lrvdijk/ledstrip-dmx-receiver/led-strip-dmx.kicad_pcb

## KiCad design led-strip-dmx.kicad_pcb (2016-02-02)

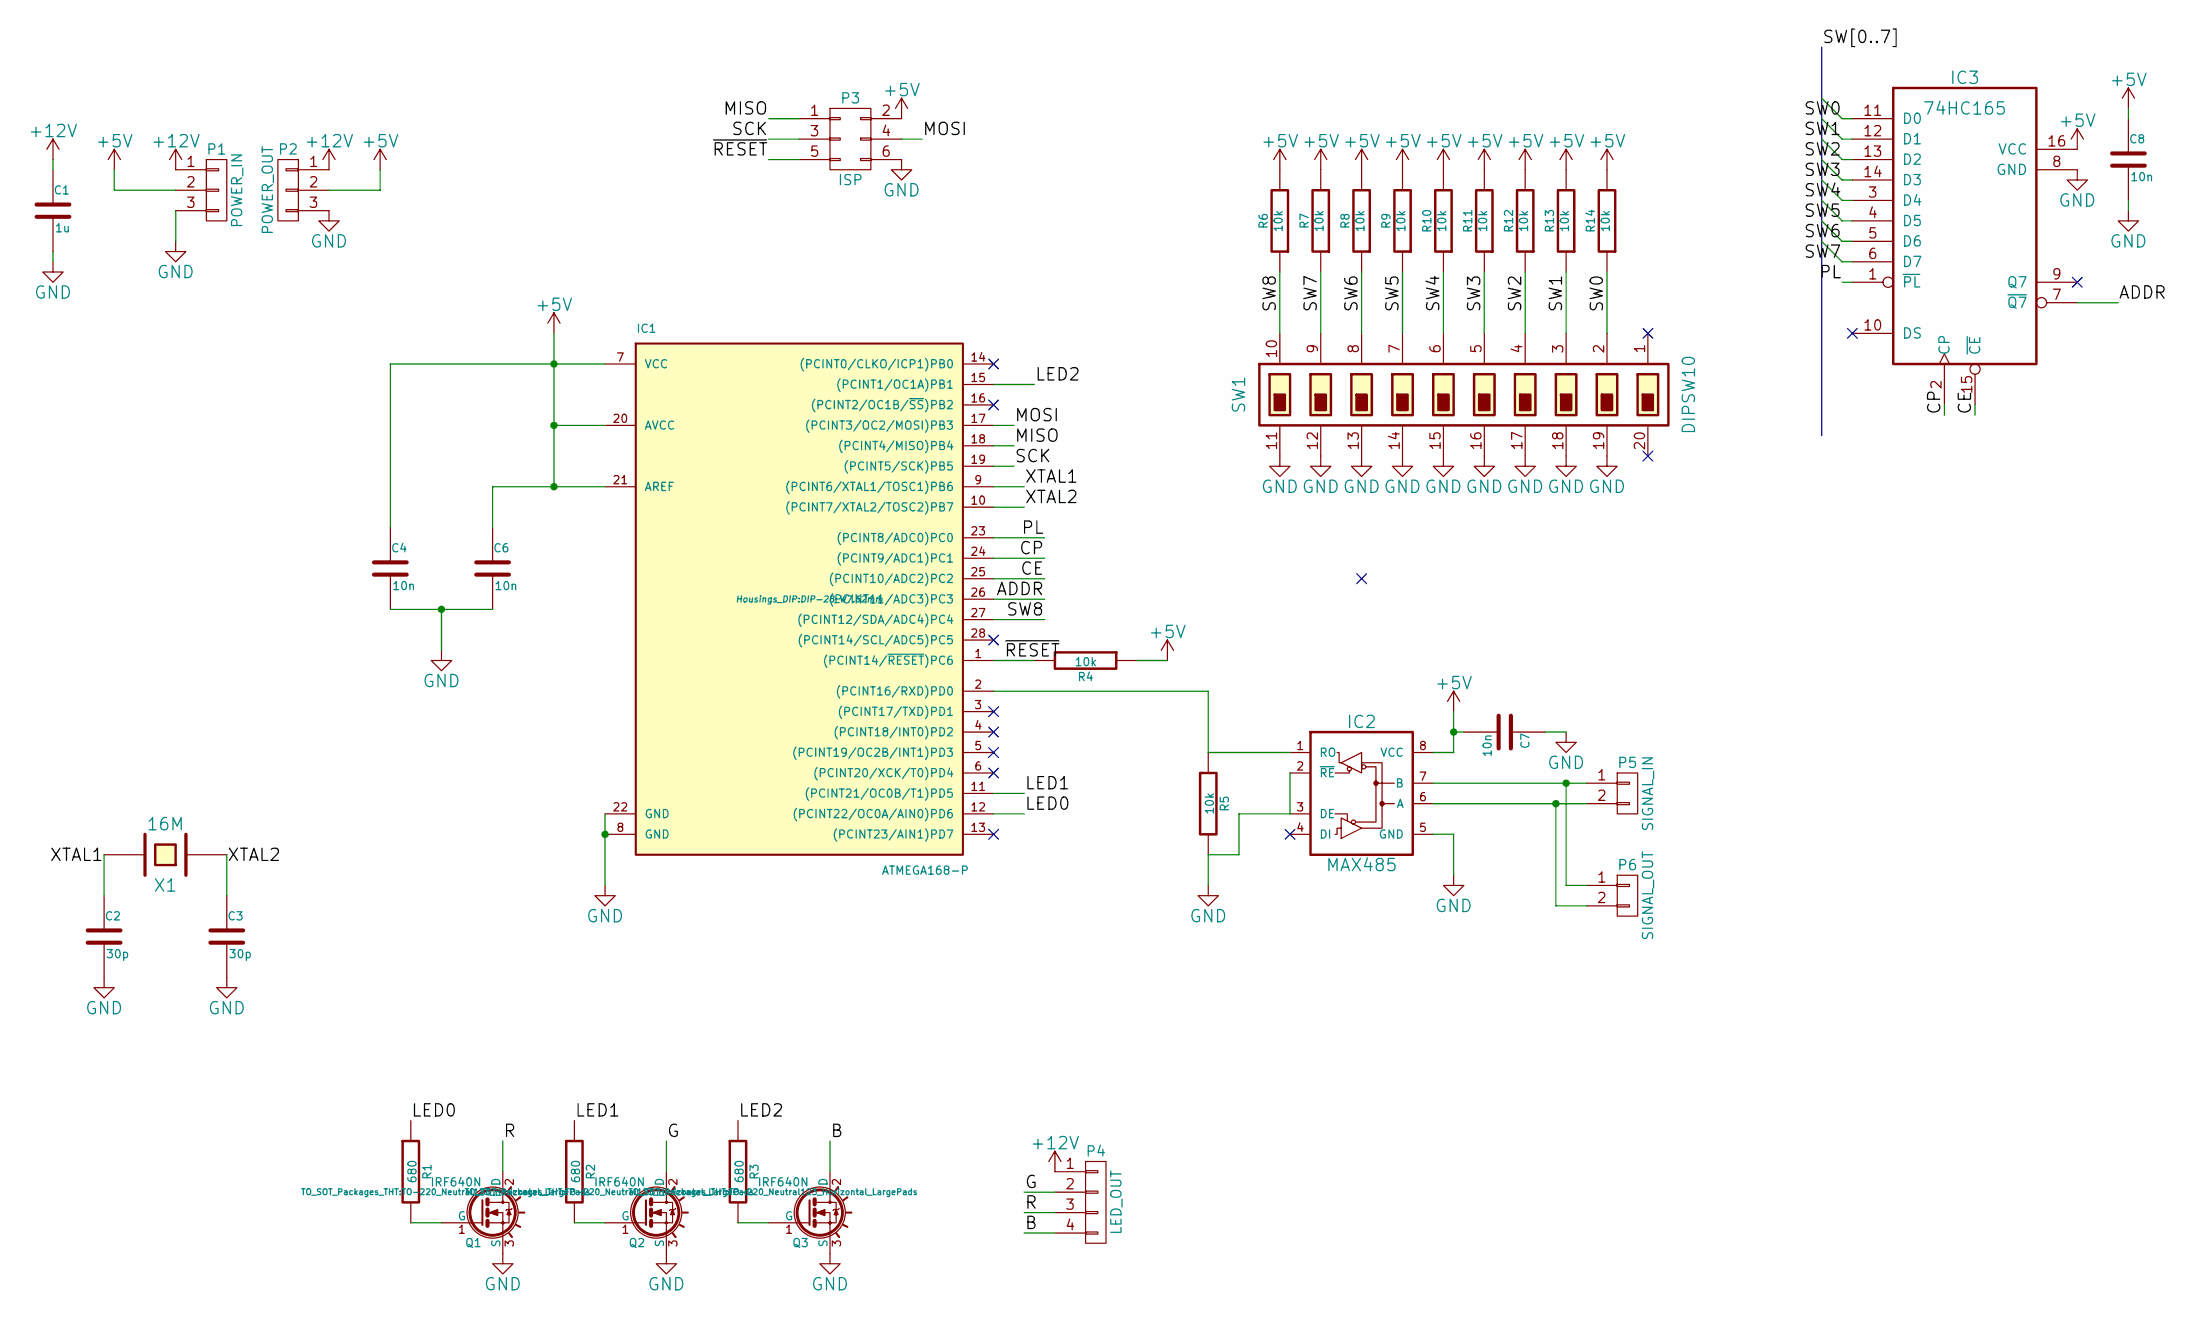
[picture p1: schematic led-strip-dmx.sch, DMX Receiver]

Parts:
C1: 1u; Elko_vert_11.2x6.3mm_RM2.5
C2, C3: 30p; C_Disc_D3_P2.5
C4, C6, C7, C8: 10n; C_Disc_D3_P2.5
IC1: ATMEGA168-P; DIP-28_W7.62mm
IC2: MAX485; DIP-8_W7.62mm
IC3: 74HC165; DIP-16_W7.62mm
P1: POWER_IN; Pin_Header_Straight_1x03
P2: POWER_OUT; Pin_Header_Straight_1x03
P3: ISP; Pin_Header_Straight_2x03
P4: LED_OUT; pin_strip_2mm_4
P5: SIGNAL_IN; Pin_Header_Straight_2x01
P6: SIGNAL_OUT; Pin_Header_Straight_2x01
Q1, Q2, Q3: IRF640N; TO-220_Neutral123_Horizontal_LargePads
R1, R2, R3: 680; Resistor_Horizontal_RM10mm
R4, R5, R6, R7, R8, R9, R10, R11, R12, R13, R14: 10k; Resistor_Horizontal_RM10mm
SW1: DIPSW10; DIP-20_W7.62mm
X1: 16M; HC-49V

Connections:
+5V: C4.1, C6.1, C7.2, C8.1, IC1.7 (VCC), IC1.20 (AVCC), IC1.21 (AREF), IC2.8 (VCC), IC3.16 (VCC), P1.2, P2.2, P3.2, R4.1, R6.2, R7.2, R8.2, R9.2, R10.2, R11.2, R12.2, R13.2, R14.2
+12V: C1.1, P1.1, P2.1, P4.1
/ADDR: IC1.26 ((PCINT11/ADC3)PC3), IC3.7 (~Q7)
/B: P4.4, Q3.2 (D)
/CE: IC1.25 ((PCINT10/ADC2)PC2), IC3.15 (~CE)
/CP: IC1.24 ((PCINT9/ADC1)PC1), IC3.2 (CP)
/G: P4.2, Q2.2 (D)
/LED0: IC1.12 ((PCINT22/OC0A/AIN0)PD6), R1.1
/LED1: IC1.11 ((PCINT21/OC0B/T1)PD5), R2.1
/LED2: IC1.15 ((PCINT1/OC1A)PB1), R3.1
/MISO: IC1.18 ((PCINT4/MISO)PB4), P3.1
/MOSI: IC1.17 ((PCINT3/OC2/MOSI)PB3), P3.4
/PL: IC1.23 ((PCINT8/ADC0)PC0), IC3.1 (~PL)
/R: P4.3, Q1.2 (D)
/SCK: IC1.19 ((PCINT5/SCK)PB5), P3.3
/SW0: IC3.11 (D0), R14.1, SW1.2
/SW1: IC3.12 (D1), R13.1, SW1.3
/SW2: IC3.13 (D2), R12.1, SW1.4
/SW3: IC3.14 (D3), R11.1, SW1.5
/SW4: IC3.3 (D4), R10.1, SW1.6
/SW5: IC3.4 (D5), R9.1, SW1.7
/SW6: IC3.5 (D6), R8.1, SW1.8
/SW7: IC3.6 (D7), R7.1, SW1.9
/SW8: IC1.27 ((PCINT12/SDA/ADC4)PC4), R6.1, SW1.10
/XTAL1: C2.1, IC1.9 ((PCINT6/XTAL1/TOSC1)PB6), X1.2
/XTAL2: C3.1, IC1.10 ((PCINT7/XTAL2/TOSC2)PB7), X1.1
/~RESET: IC1.1 ((PCINT14/~RESET~)PC6), P3.5, R4.2
GND: C1.2, C2.2, C3.2, C4.2, C6.2, C7.1, C8.2, IC1.8 (GND), IC1.22 (GND), IC2.2 (~RE), IC2.3 (DE), IC2.5 (GND), IC3.8 (GND), P1.3, P2.3, P3.6, Q1.3 (S), Q2.3 (S), Q3.3 (S), R5.2, SW1.11, SW1.12, SW1.13, SW1.14, SW1.15, SW1.16, SW1.17, SW1.18, SW1.19
unnamed: IC1.2 ((PCINT16/RXD)PD0), IC2.1 (RO), R5.1
unnamed: IC2.6 (A), P5.2, P6.2
unnamed: IC2.7 (B), P5.1, P6.1
unnamed: Q1.1 (G), R1.2
unnamed: Q2.1 (G), R2.2
unnamed: Q3.1 (G), R3.2

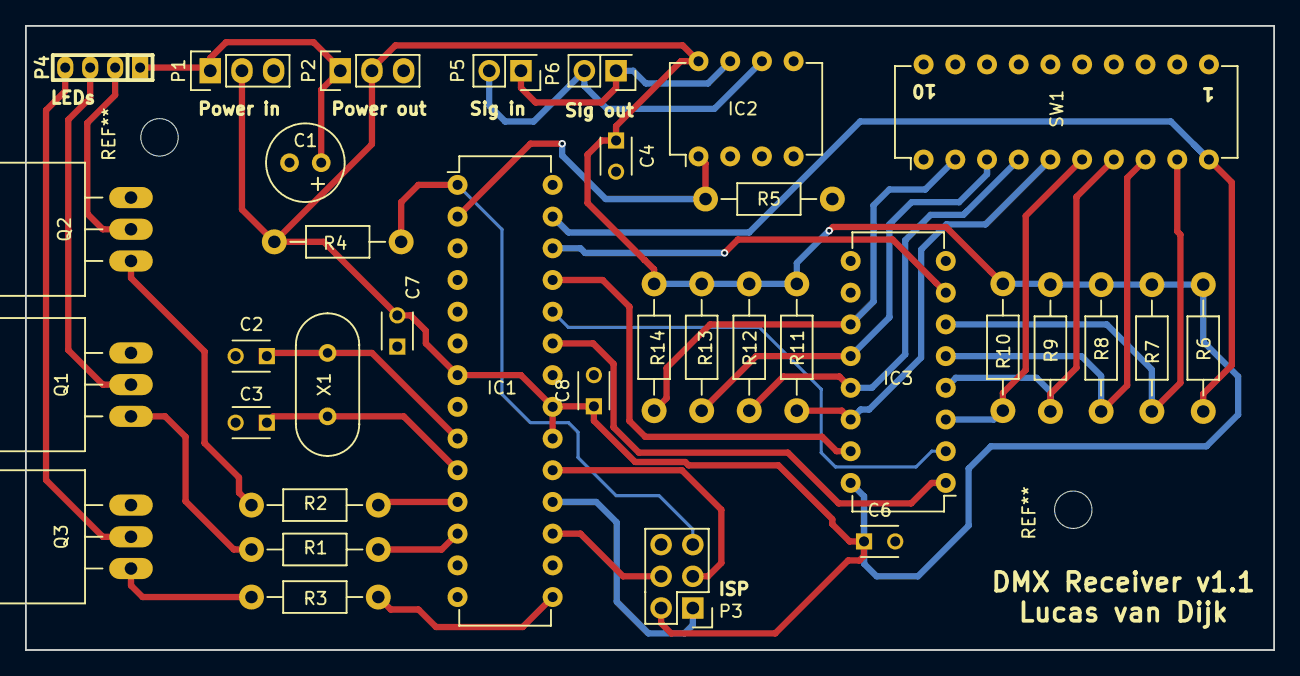
[picture p2: board led-strip-dmx.kicad_pcb from above]

Board: 2 copper layers, 100.0 x 50.0 mm, 35 parts (0 on the bottom side), 34 nets.
