lrvdijk/ledstrip-dmx-receiver/(commit log)

2015-11-03 Add schematics for DMX Receiver
    [led-strip-dmx.sch]
2015-11-03 Add PCB design
    [led-strip-dmx.kicad_pcb]
2016-02-02 Fix a few major issues on the PCB
    - Used wrong pin order for LED transistors
    - Right half of the PCB did not get any power
    [led-strip-dmx.kicad_pcb, led-strip-dmx.sch]
2016-02-02 Start with the AVR C source code
    Currently it contains functions to read the 74HC165 shift
    register.
2016-10-29 Increase clock pre-scaling for PWM
2016-10-29 Set OCRXX registers om timer overflow
    Possible fix for flickering led strips. Also increase startup time
    of the AVR.
    [main.cpp]
